victaf/linefollower/code/proof of concepts/wireless communication/readme.md

# draadloze communicatie proof of concept
minimale hard- en software waarmee aangetoond wordt dat duplex kan gecommuniceerd worden tussen de microcontroller en een [laptop|smartphone] (schappen wat niet past), gebruik makend van [programma] (in te vullen)
<br />
### configuratie
  #### verbind de CH-05 module met de arduino:
  - GND met GND
  - VCC met 5V
  - TX met D0(RX)
  - RX met D1(TX)
#### upload bluetooth_com.ino naar de arduino

### gebruiksaanwijzing
