victaf/linefollower/technische tekeningen/elektronisch/SCH_Schematic1_1-P1_2025-11-23 (1).png

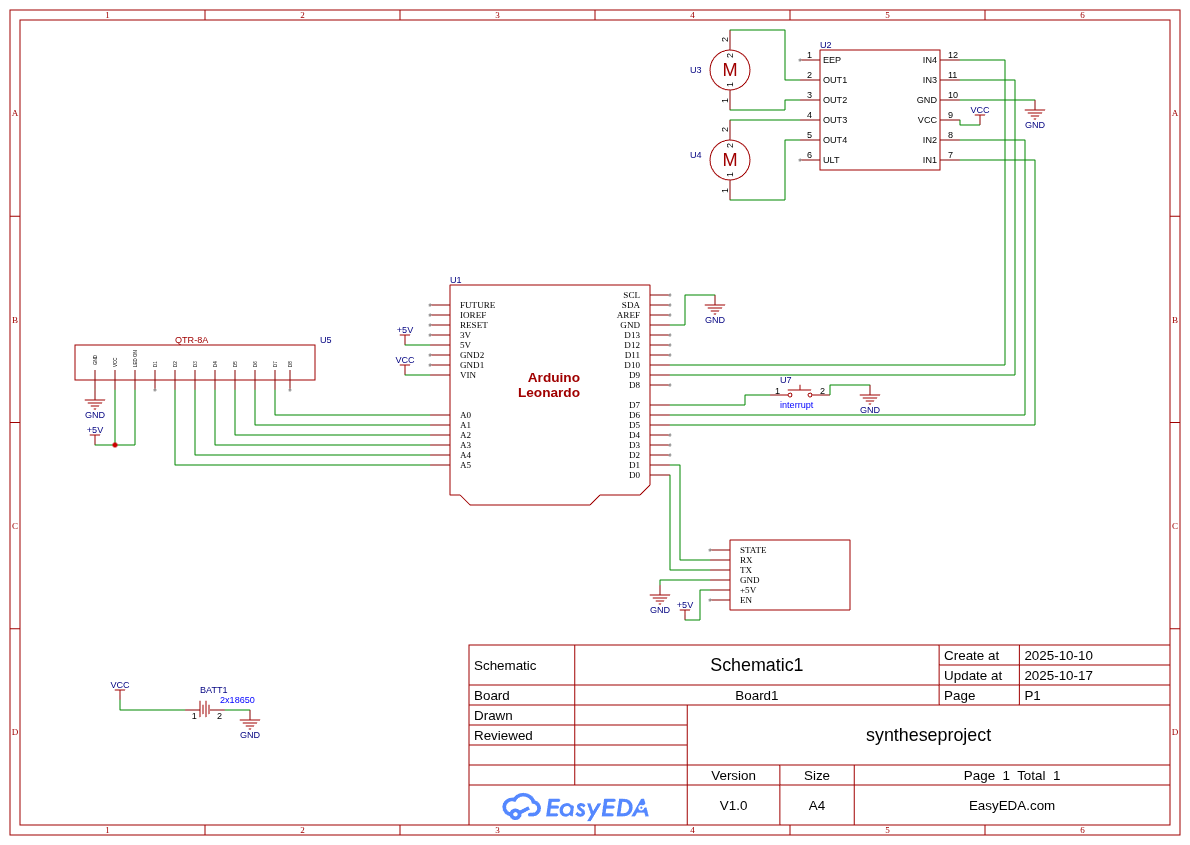
technische tekeningen/elektronisch/SCH_Schematic1_1-P1_2025-11-23 (1).png
