victaf/linefollower/bill of materials/readme.md

## bill of materials
<br />

|volgnummer|naam|omschrijving|nieuw/recup|kostprijs/stuk|aantal|subtotaal|
|---|----|---|---|---|---|---|
|1|Motor|Aslong JGA12-N20-30 DC-Transmissiemotor 6V - 500RPM|nieuw|€4,5|2|€9|
|2|Hbrug|DRV8833 Bipolaire Stappenmotor- en DC-Motoraansturing|nieuw|€3|1|€3|
|3|Bluetooth comunicatie module|Bluetooth HC-05 module RF transceiver Master en Slave|nieuw|€10,5|1|€10,5|
|4|lijn detectie sensor|8x IR Lijn Tracking Module (HY-S301)|nieuw|€3,5|1|€3,5|
|5|microcontroller|atmega32u4 leonardo ontwikkelbord WPB103|recup|€19,90|1|€19,90|
|6|wielen|Pololu wiel 32×7 mm paar - wit|nieuw|€4,25|1|€4,25|
|7|prototype board|Testprint 50x100mm met soldeereilandjes|recup|€1,15|1|€1,15|
|8| M5x20 bouten|pak van 15|recup|€4,10|1|€4,10|
|9|dupont connectors|Dupont Jumper kabels 40 stuks (Male-Male) 10cm|recup|€1,7|1|€1,7|
|10| headers mannelijk|Extra lange afbreekbare vergulde contacten 16 pins Mannelijk - Mannelijk - 5 pcs|nieuw|€3,94|1|€3,94|
|11| headers vrouwelijk|Shield Stacking headers voor Arduino|nieuw|€2,75|1|€2,75|
|12| kabel voor te solderen| 0.25mm²| recup| €20|1|€20|
|13| krimpkous| 4,5mm|recup|€1,45|1|€1,45|
|14| 18650 houder| /| nieuw|€8,50|3|25.5|
|15| lader voor 18650|5 V 18650 Lithiumbatterij Oplaadbord TP4056|recup|€2,20|1|€2,20|
||||totaal|€62,44|totaal inclusief recup|€112,94|
