victaf/linefollower/technische tekeningen/mechanisch/frame.step

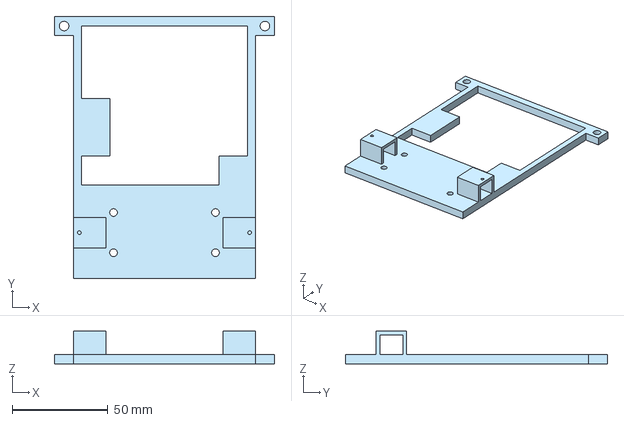
[picture p3: CAD file, 2025-12-12]
technische tekeningen/mechanisch/frame.step
115.0 x 137.0 x 17.2 mm
