victaf/linefollower/(list of files, cad)

Other CAD files:
technische tekeningen/mechanisch/body.stl
