victaf/linefollower/technische tekeningen/elektronisch/SCH_Schematic1_2025-12-12.pdf

M1

M1

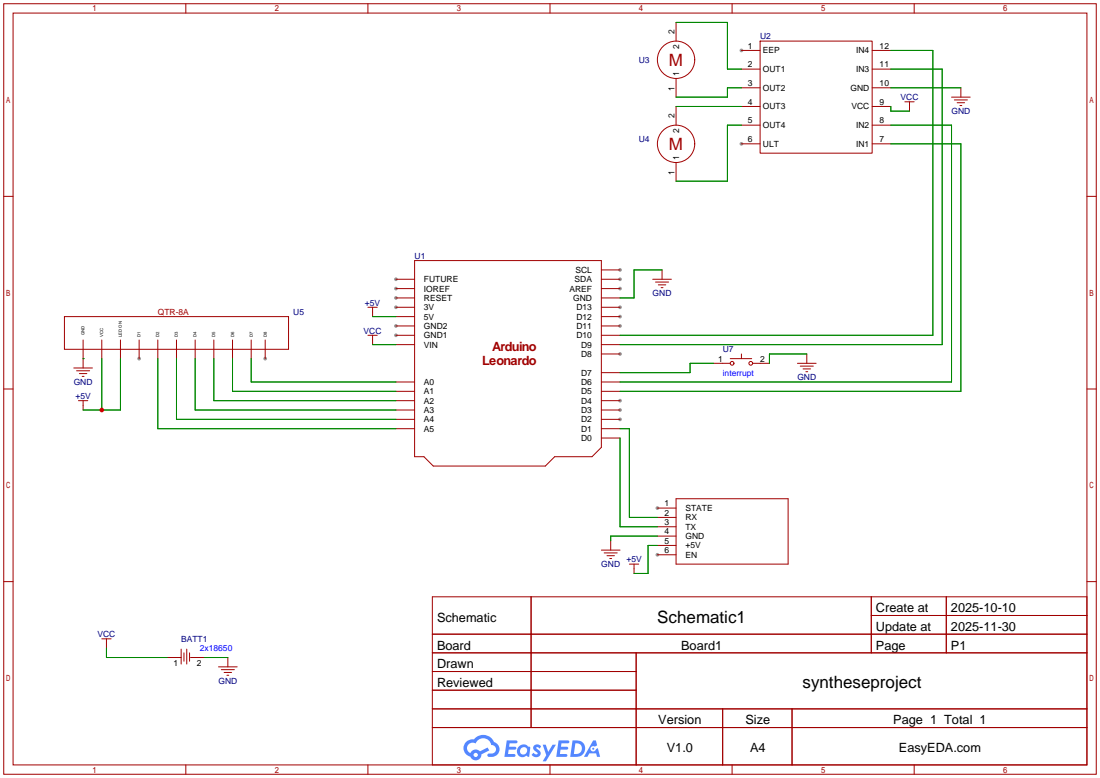
[picture p4: page 1]

Schematic | Schematic1 | Create at | 2025-10-10

Update at | 2025-11-30

Board | Board1 | Page | P1
Drawn | | syntheseproject
Reviewed

Version | Size | Page 1 Total 1
V1.0 | A4 | EasyEDA.com
