victaf/linefollower/technische tekeningen/mechanisch/assembly (1).pdf

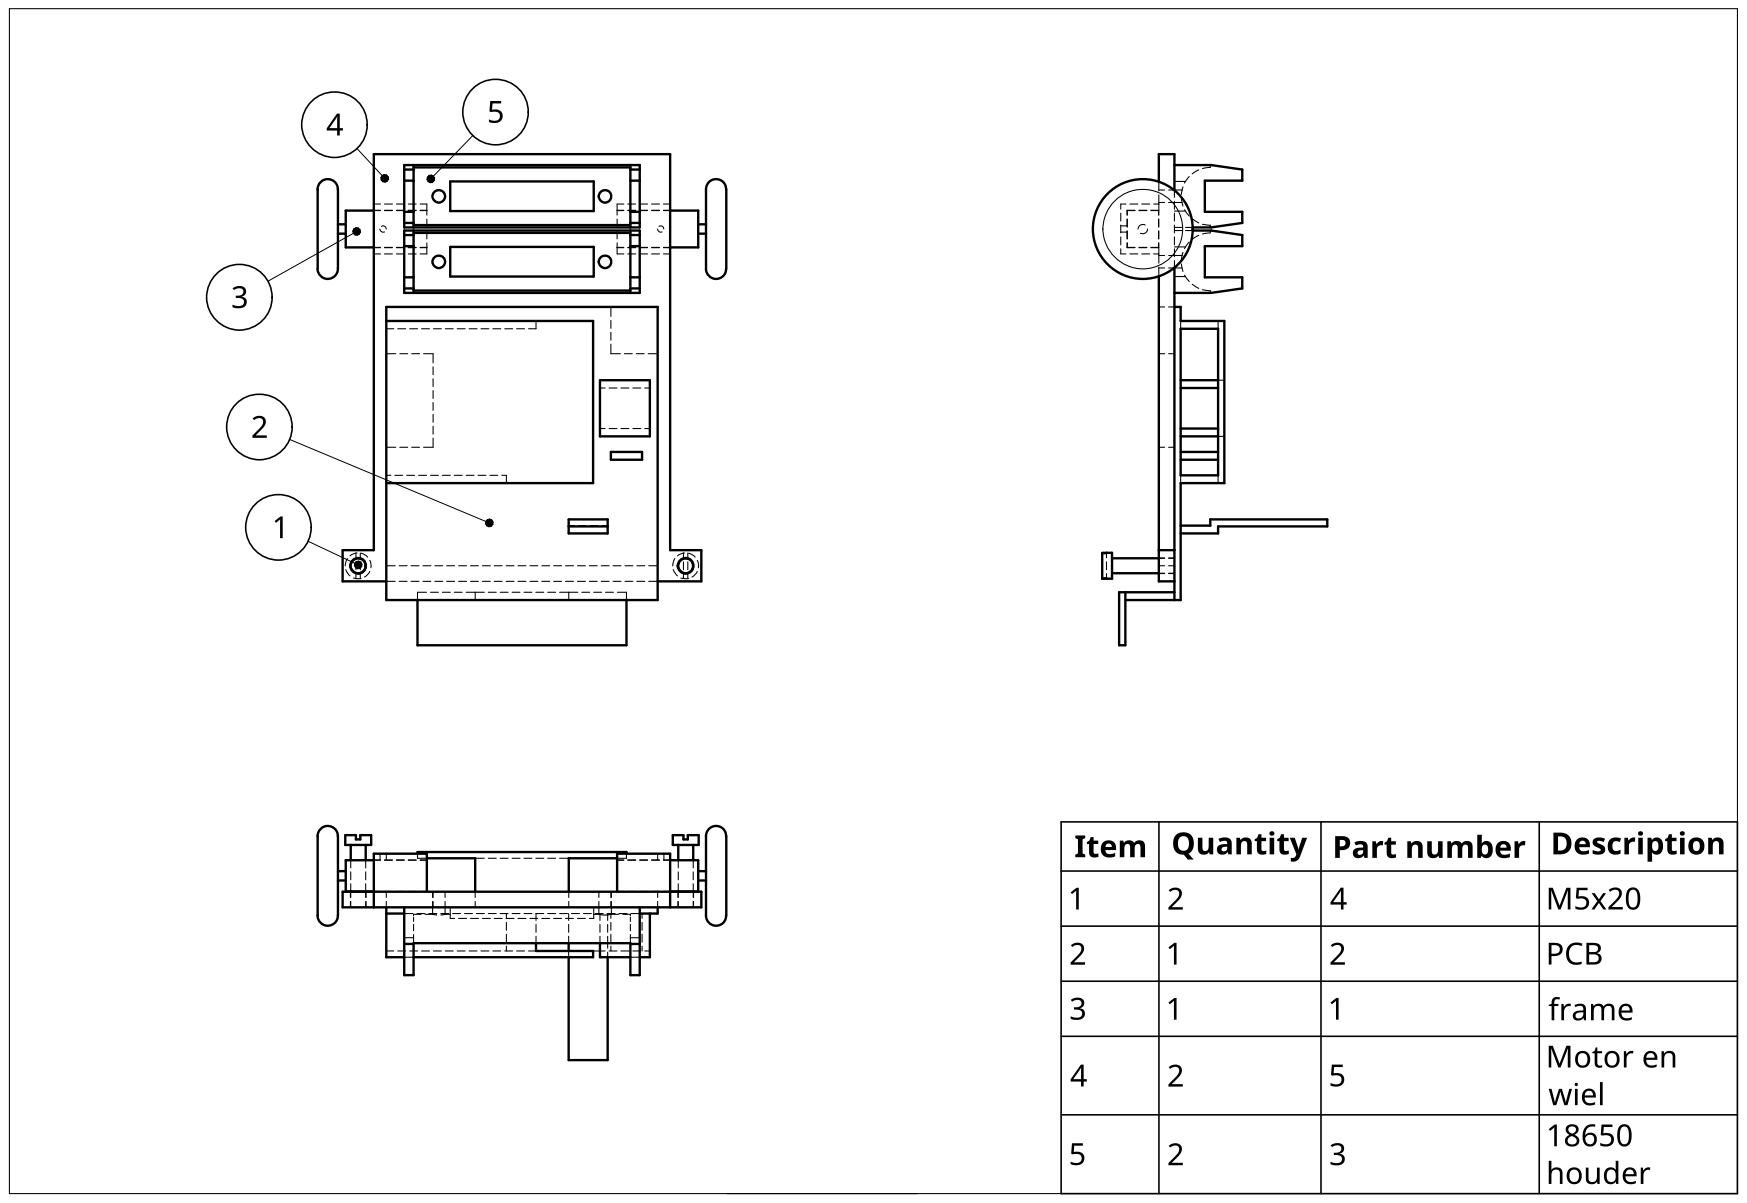
[picture p5: page 1]
