victaf/linefollower/technische tekeningen/mechanisch/3d print body.pdf

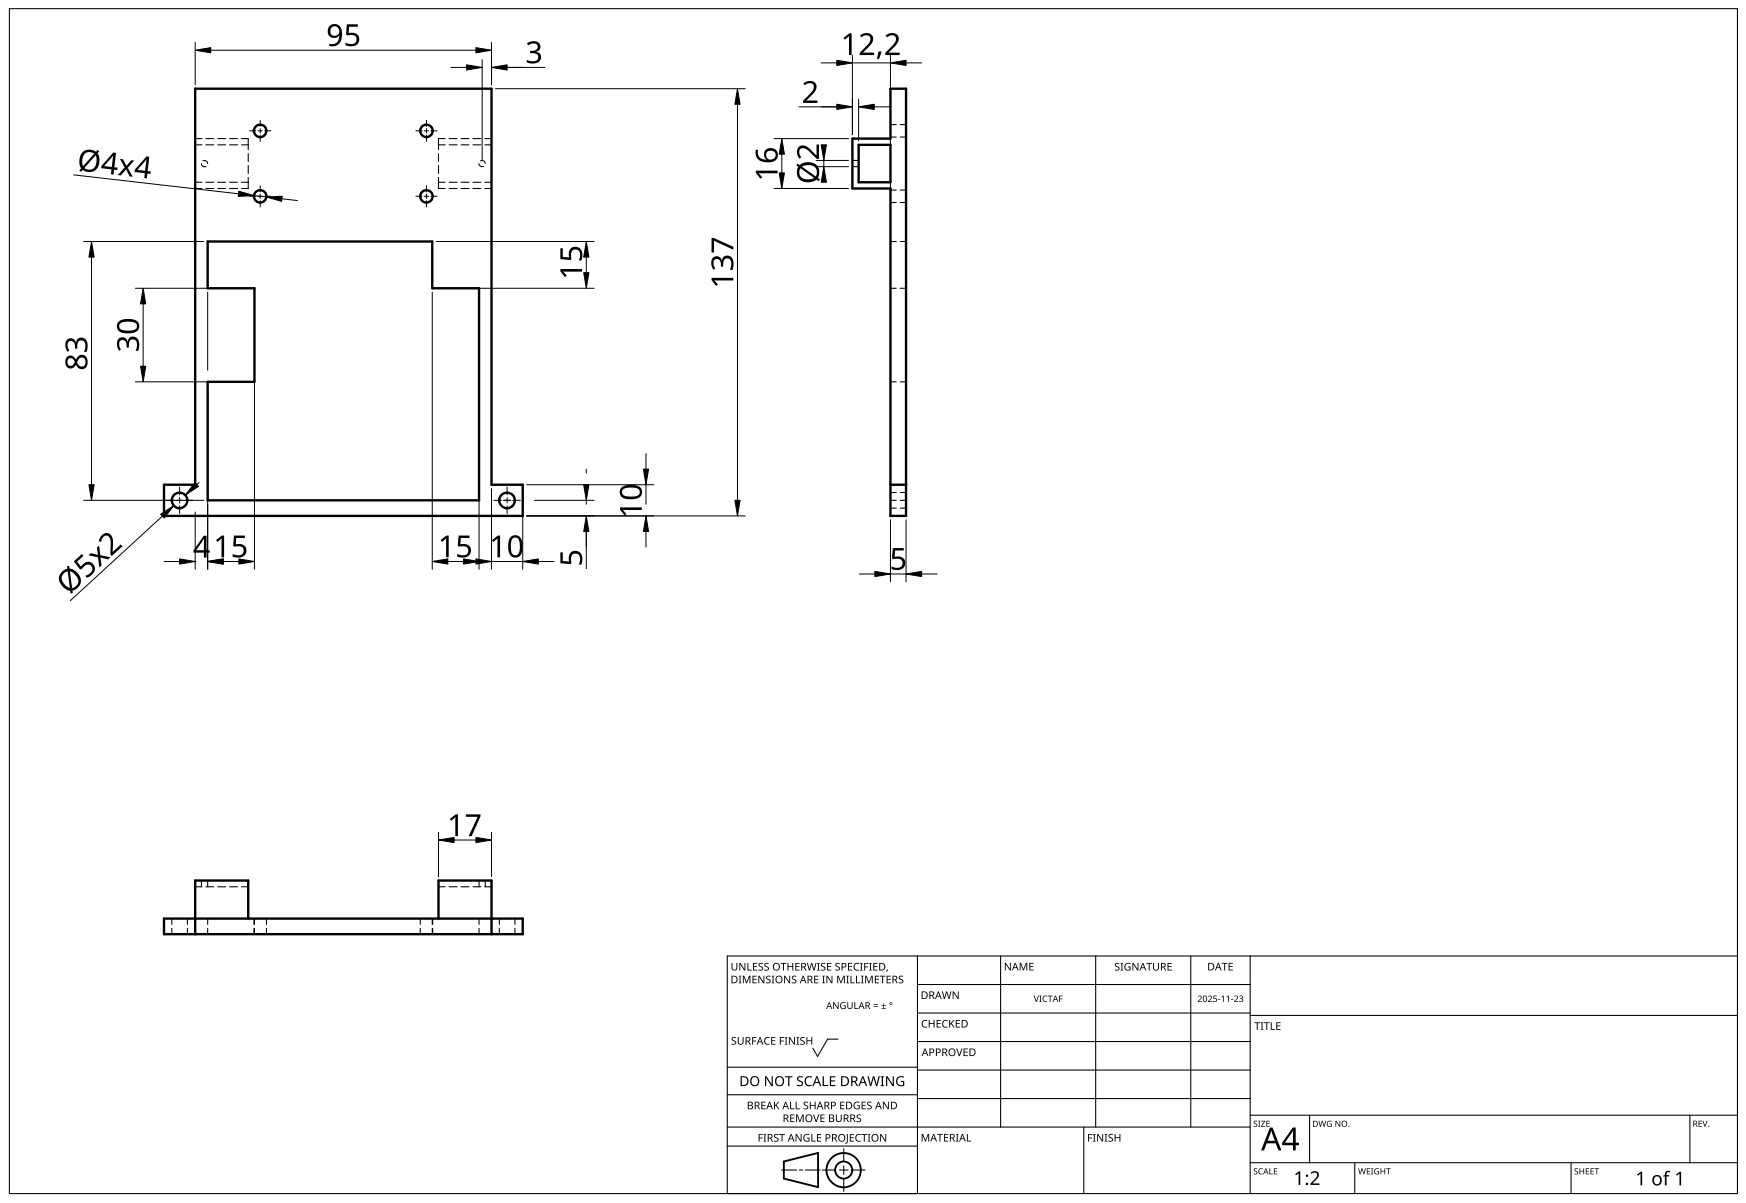
[picture p6: page 1]
