victaf/linefollower/(list of files, drawings)

Other design files:
technische tekeningen/elektronisch/syntheseproject_2025-11-30.epro
